karamo/esp32-e22-lora-board/ESP32-E22-PCB_ChatExport_2026-04-16/chats/chat_562951940640114/topic_11812/photos/photo_120@05-12-2025_15-44-13.jpg

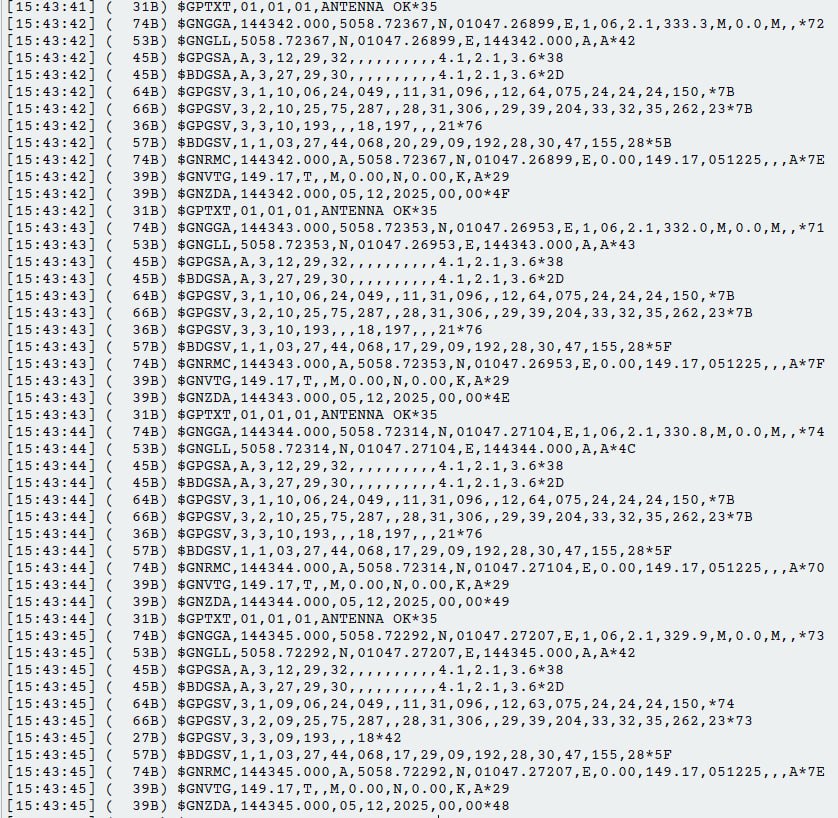
ESP32-E22-PCB_ChatExport_2026-04-16/chats/chat_562951940640114/topic_11812/photos/photo_120@05-12-2025_15-44-13.jpg
