karamo/esp32-e22-lora-board/ESP32-E22-PCB_ChatExport_2026-04-16/chats/chat_562951940640114/topic_11812/photos/photo_38@24-03-2025_12-01-31.jpg

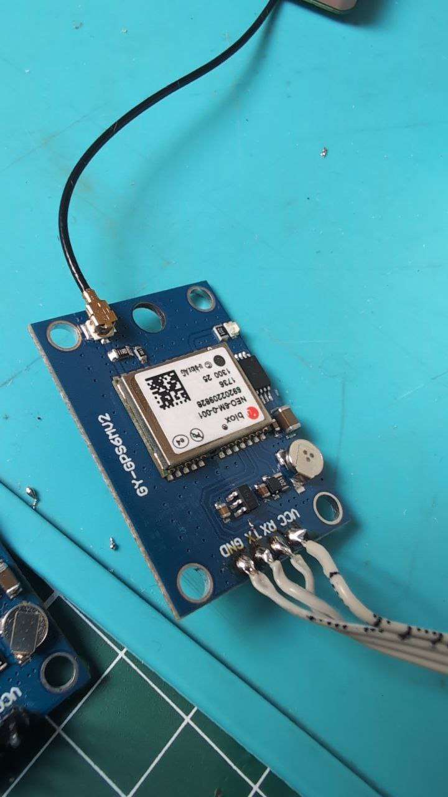
ESP32-E22-PCB_ChatExport_2026-04-16/chats/chat_562951940640114/topic_11812/photos/photo_38@24-03-2025_12-01-31.jpg
