karamo/esp32-e22-lora-board/README.md

# ESP32-E22-LoRa-board
Carrier Board for LoRa Tranceiver like E22-400M33S and ESP32 MCU

### Main Parts List:

EBYTE E22-400M33S (2W/33dBm) https://www.amazon.de/dp/B0BMP99S3D

if needed: E22->N Pigtail: https://www.amazon.de/dp/B0C8J131PD

ESP32 Board Dev Kit C V4 **!!! von AZ Delivery nicht mehr verfügbar !!!**  
https://www.amazon.de/AOICRIE-ESP32-DevKitC-Kernplatine-ESP32-Entwicklungsplatine-ESP32-WROOM-32D-WiFi-Bluetooth-Entwicklungsplatine/dp/B0B8VRPN36  
https://de.aliexpress.com/item/4000090521976.html

Adapter-Kabel zum flashen im eingebauten Zustand https://www.amazon.de/dp/B096843RY3/

BME/BMP280 3,3V https://www.amazon.de/dp/B07FS95JXT/

OLED-Display (VCC-GND-SCL-SDA): https://www.amazon.de/dp/B0C9LJ898Z/

GPS https://www.amazon.de/dp/B0D3DJ58R8/

Reichelt: https://www.reichelt.de/my/2192127

### Versions Info
**V 2.1.2  PCB** für Querformat im Gehäuse für Aussenmontage - alle Anschlüsse auf der Unterseite des Gehäuses  
oder PCB vertikale Einbau

___
