karamo/esp32-e22-lora-board/ESP32-E22-PCB_ChatExport_2026-04-16/chats/chat_562951940640114/topic_11812/files/at6558.pdf_thumb.jpg

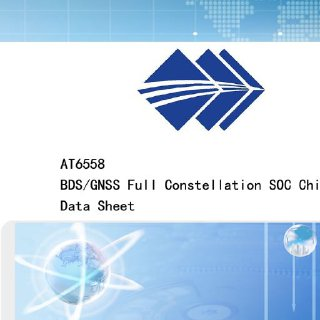
ESP32-E22-PCB_ChatExport_2026-04-16/chats/chat_562951940640114/topic_11812/files/at6558.pdf_thumb.jpg
