karamo/esp32-e22-lora-board/ESP32-E22_V2.1.2/PCB-Assembly/README.md

# Bestückungshinweise PCB V2.1.2

Bestückungsreihenfolge, Varianten und Inbetriebnahme des PCB V2.1.2  

Bilder zum fertigen Gerät sind hier zu finden:  
https://github.com/DK9BT/esp32-e22-lora-board/tree/main/ESP32-E22_V2.1.2/pdf  
Fertig bestückte Varianten sind hier zu finden:  
https://github.com/DK9BT/esp32-e22-lora-board/tree/main/gallery

## 1) Minimalbestückung
* Die folgenden BT sind das absolute Minimum für die grundsätzliche Funktion.
* Über die USB-mikro Buchse am ESP32 kann auch das E22-Modul versorgt werden, wenn ein passendes USB-Netzgerät verwendet wird, welches mind. 2A bereitstellen kann.

### 1.1 Key-Components
* **PCB V2.1.2**
* **U1 = ESP32-DevKitC-V4**
* **U2 = OLED 0,96"**
* **U3 = E22-400M30S** (30dBm) od. **E22-400M33S** (33dBm) od. **E22-900M30S** (30dBm!)

### 1.2 Einbau-Varianten für U3 = E22-fffM3xS
> [!NOTE]
> **Dieses BT sollte als Erstes bestückt werden, um gut an die Lötstellen zu kommen.**

**a)** Das **E22-Modul** ist für **SMD-Direktlötung** vorgesehen. Der NT ist, dass es bei einem Defekt schwieriger abzulöten ist.  
E22-direkt  

**b)** **E22-Modul auf Sockel (Variante für PCB V2.1.2)**  
Obwohl der Pin-Abstand des E22-Moduls 2,50mm beträgt, ist es trotzdem möglich, Stifte und Buchsen im RM 2,54 zu verwenden.  
Bei dieser Art der Bestückung wird sozusagen ein Stecksockel aus einfachen, günstigen und handelsüblichen Teilen hergestellt.  
In einer späteren Version wird es eine Sockeladapterplatine geben und eine modifizierte PCB.

<ins>**Schritt 1:**</ins> Durchkontaktierte Lochrasterplatte 35x27mm (13x10 Löcher) mit **2x 8pol** + **2x 3pol Pfosten-Buchsen** bestücken und mit Stiftleisten stabilisieren.  
E22_sockelPCBE22_SocBu  

<ins>**Schritt 2:**</ins> verlöten und Lötstellen plan feilen, damit das E22-Modul plan aufliegen kann und gut verlötbar ist.  
E22_SoctopE22_Socbot  

<ins>**Schritt 3:**</ins> **2x 8pol** + **2x 3pol Pfostenstecker gewinkelt** zur Stabilisierung in die Pfosten-Buchsen stecken und das kürzere Ende noch weiter kürzen.  
E22_SMD90E22_SMDa  

<ins>**Schritt 4:**</ins> auf die PCB wie ein SMD-BT auflöten.  
E22_SMDb  

<ins>**Schritt 5:**</ins> **C3** (220..470µF, liegender Einbau) & **C4** (100nF) bestücken.

### 1.3 Einbau-Varianten für U1 = ESP32-DevKitC V4
Die **V4** ist die derzeit neueste Version. Es können aber grundsätzlich auch die **V1**- od. **V4**-Module verwendet werden.  
> [!NOTE]
> Die Unterschiede werden an anderer Stelle detailliert dargestellt. [!TODO]

* **a)** Normalerweise verwendet man eine Pfosten-Steckverbindung, wobei die Buchsenleisten in das PCB eingelötet sind und die Pfostenstecker sich am ESP32-Modul befinden, **je 2x 19-pol**:  
ESP32_BuLeiste  

* **b)** Es können aber auch IC-Sockelstifte & Sockelbuchsen verwendet werden. Dies hat den Vorteil, dass das ESP32-Modul problemlos auf ein Steckbrett eingesteckt werden kann.  
ESP32_IC-Sockel  

### 1.4 OLED 0,96"
Für das OLED sind 2 Positionen 0°=Hochformat & 90°=Querformat (J11) vorgesehen, die mit **2x 4-pol Bu-Streifen** bestückt werden.  
Die OLED gibt es in grundsätzlich 2 verschiedenen Pin-Anordnungen. Die angegebene (**VCC-GND-SCL-SDA**) ist bereits auf der PCB verdrahtet. Falls man VCC <> GND umdrehen möchte, dann sind auf der Rückseiten 2 Leiterbahnen zu unterbrechen und 2 Drahtbrücken herzustellen (JP1 & JP2).  
Bei manchen OLEDs (rechts im Bild) kann man noch die **I²C**-Adresse von **`0x78`** auf **`0x7A`** ändern.  
Mit einem I²C-Scanner werden **`0x78` >> `0x3C`** und **`0x7A` >> `0x3D`** erkannt (7-Bit Format).  
Zusätzlich können auf manchen Modulen direkt die **VCC<>GND** durch die **J1/J2/J3/J4** im Foto rechts vertauscht werden.  
Das linke OLED verwendet einen **SH1106**-Driver (132x64 pixel), das rechte einen **SSD1306**-Driver (128x64 pixel).  
OLED_SH1106-SSD1306  
Das OLED-Board kann über eine Abstandshülse Ø4x11 mit M2 Gewindebohrung beidseits mit M2x5 Schrauben auf dem PCB mechanisch fixiert werden.  
U1+U2+C3+C4OLEDfix

### 1.5 User Button
Ein Taster **SW1** ist an **GPIO12** angeschlossen. Parallel dazu kann über **J10** ein Taster extern, zB. am Gehäuse, verbunden werden.  
Für **MeshCom** muss er erstmalig mit **`--button on`** aktiviert werden.  
Button

### 1.6 Testlauf #1
Beim Online-Flash Tool https://esptool.oevsv.at/ ist **E22** auszuwählen. (Hat auch eine Console. Chromium Browsers only!)  
Und läuft grundsätzlich, mit Minimalbestückung und auch ohne HF (E22).  
Testlauf1

### 1.7 Varianten Antenne
* Das E22-Modul hat einen IPEX-Stecker. Hier kann eine Antenne angeschlossen werden über
  * ein **IPEX-SMA-Buchse Adapterkabel** oder
  * als Gehäusedurchführung eine dichte **U.FL IPEX <> N-Buchse** https://www.amazon.de/dp/B0C8J131PD oder
  * Alternativ eine IPEX <> SMA-Einbaubuchse: ...
 
* Beim Einbau der **SMA-Buchse J8 + R8** (0Ω=Drahtbrücke auf der Rückseite) über
  * einen SMA-St <> N-Bu mit Flansch, aber ohne Dichtung (ev. Dichtfolie verwenden):
https://www.reichelt.at/at/de/shop/produkt/hf_n_buchse_sma_flanschbuchse-141249
  * eine SMA-Bu <> SMA-Bu:  
https://www.conrad.at/de/p/bkl-electronic-0409093-0409093-sma-adapter-sma-buchse-sma-buchse-1-st-457659.html

Bei allen Varianten ist eine mechanische Entkopplung zwischen Antenne<>Gehäuse<>PCB gegeben.  

## 2) Spannungsversorgung
Für die Spannungsversorgung stehen mehrere Möglichkeiten zur Verfügung.  
### ❗ 🟡 Extrem wichtig ist aber, dass die 2x 470µF Elkos und alle 100nF KerKos bestückt sind, und dass ein Netzgerät mit ausreichender Stromergiebigkeit verwendet wird! Bei hochwertigen Netzteilen sollten 2A reichen, das die Stromspitzen auch wegpuffern kann. Besser sind Netzteile mit 3A nominell, wie sie z.B. auch für RaspberryPi verwendet werden. Und möglichst kurze und niederohmige Verbindungsleitung zwischen Netzgerät und PCB.
### ❗ 🟡 Ebenso sollte C2 10µF NICHT bestückt werden, bei Verwendung des ESP32-DevKitC-V4 Moduls!

### 2.1 USB-Micro via ESP32
Die Spannungsversorgung kann über die USB-Mikro-Buchse des ESP32-Moduls erfolgen, wenn ein geeignetes USB-Netzteil verwendet wird, welches bis zu 3A liefern kann. Mindestens jedoch 2,5A. Solche Netzteile werden z.B. auch für die Versorgung von RapberryPi u.a. verwendet.  

### 2.2 Versorgung über USB-C
Das **USB-C BreakOut-Board** mit der stehenden USB-C Buchse ermöglicht ein leichtes Anstecken der externen Versorgung, speziell bei Einbau in ein Gehäuse. https://de.aliexpress.com/item/1005007821332638.html  

<ins>**Funktion:**</ins>  
Für USB-C PD (Power Delivery) ist ein Kommunikations-IC an CC1 & CC2 erforderlich.
Wenn dieser nicht vorhanden ist, dann kann nur 5V geliefert werden und über die Widerstände an CC1 & CC2 wird der Strom "eingestellt". Die Widerstände **R3** & **R4** mit jeweils **5k1** signalisieren dem USB-Netzteils, dass es **5V/3A** liefern darf. Die Schottky-Diode **D1** verhindert eine Rückspeisung, falls mehrere Spannungsquellen angeschlossen sind.  

<ins>**Schritt 1:**</ins> Die Widerstände **R3** & **R4** (je 5k1) auf der Rückseite bestücken und auf der Oberseite Lötpins auf ein Minimum kürzen.  
R3-R4  

<ins>**Schritt 2:**</ins> Die Diode **D1** und eine längere **4-pol** Stiftleiste **J2** mit Gesamtlänge **15mm** auf der Oberseite bestücken.  
Dann 2-3 Lagen Doppelklebepads zur Unterstützung des USB-C Adapter Boards aufbringen ...  
J2-D1  

<ins>**Schritt 3:**</ins> das USB-C Adapter Board aufkleben und verlöten. An die überstehende Stiftleiste kann eine USB-C Einbaubuchse mit Kabel angesteckt werden.  
USB-Bu  

Die Versorgung über die USB-C-Buchse funktioniert.  
USB-C_ok  

### 2.3 Versorgung über DC/DC HW-613
> [!NOTE]
> Funktionsbeschreibung [!TODO]
Bei Versorgung über ein externes Netzgerät über Schraubklemmen ist zwar auch eine Schottky-Diode erforderlich, aber bei Verwendung des **DC/DC-Wandler-Boards HW-613** (bis 1,5A) kann mit bis zu 6-24V DC versorgt werden und die Ausgangsspannung kann eingestellt werden, bzw. fix durch Lötbrücken.  

**D5** 1N4007 o.ä. & **C5** 100nF bestücken  
D5C5  

Eine 4-pol Stiftleiste auf den DC/DC-Wandler **U4 HW-613** löten.  
DCDC  
> [!IMPORTANT]
> Auf einem Steckbrett den DC/DC-Wandler mit dem Poti auf **5,3V** Ausgangsspannung einstellen.

> [!CAUTION]
> Es ist nicht zu empfehlen, die ADJ-Leiterbahn zu unterbrechen und den 5V-Jumper zu löten, ausser man hat ein sehr gute Lupe (Mikroskop) und entsprechendes Schneidwerkzeug. Siehe https://protosupplies.com/product/mp2315-mini-adjustable-dc-dc-step-down-module/  
> DCDCjmp  

[img U4 eingelötet] & D2 auf Oberseite & J3  

Weitere BT: C6, D4 (alternativ D3)  
Weitere BT: F1, D5  
• Zusätzlich ist eine **2A** Feinsicherung **F1** und eine Schutzdiode **D5** (1N4004..1N4007) gegen Verpolung eingebaut.  
• Die Transient Voltage Suppressor Diode **D4** (alternativ **D3**) schützt vor ESD mit einer VBR = 5,6V min. @ I=1mA

### 2.4 Versorgung über DC/DC R-78B5.0-2.0
Statt dem günstigen DC/DC in [2.3](https://github.com/DK9BT/esp32-e22-lora-board/blob/main/ESP32-E22_V2.1.2/PCB-Assembly/README.md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) kann auch ein handeslsüblicher, aber auch teurerer Schaltregler z.B. der **RECOM R-78B5.0-2.0** verwendet werden.  
https://at.rs-online.com/web/p/schaltregler/1392959  
https://www.conrad.at/de/p/recom-r-78k5-0-2-0-dc-dc-wandler-5-v-2-a-10-w-inhalt-1-st-2887420.html  
[img 3D]

### 2.5 Versorgung über USB-C Einbaubuchse
An die überstehende Stiftleiste **J2** kann eine USB-C Einbaubuchse mit Kabel angesteckt werden.  
[Foto !TODO]

### 2.6 weiter Versorgungsmöglichkeiten (Rohfassung aus Telegram)

❗️Ich habe viele Möglichkeiten vorgesehen. Man kann einiges weglassen, wenn man weiß, was man tut. Aber man sollte auch die Schaltung verstehen.  
1️⃣ Schraubklemme kann verwendet werden, auch ohne DC/DC. Drahtbrücke einbauen.  
2️⃣ Sicherung F1 & Diode D5 müssen nicht verwendet werden, können aber.  
3️⃣ Auf die Stiftleiste J2 kann eine USB-C Einbaubuchse angesteckt werden.

• z.B. die **6-polige (VCC GND CC1 CC2 D+ D-)**, wobei ich aber noch keine genaue Belegung dazu gefunden habe.  
grafik

• es kann auch sein, dass die **5-polige (VCC GND CC D+ D-)** funktioniert. Davon habe ich eine Belegung gefunden. Wahrscheinlich gemeinsames CC, also CC1-CC2 verbunden, was aber zu dem bekannten RPi-Problem führt.
grafik

❌ Die **2-poligen (nur VCC & GND)** und die **4-poligen (VCC & GND & D- & D+)** funktionieren aber definitiv NICHT, da die CC1 & CC2 Anschlüsse fehlen und daher von dem USB-C Netzteil nur 5V/500mA bereitgestellt werden darf, außer ev. Ausnahmen, wenn man "dumme" Netzteile u/o "dumme" USB-C Anschlusskabel verwendet.

## 3) Einbau in ein Gehäuse
Enclosure (transparent) https://www.reichelt.de/de/de/shop/produkt/industriegehaeuse_120_x_80_x_60_2mm_ip65_lichtgrau-340524  
Enclosure (non-transparent) https://www.reichelt.de/de/de/shop/produkt/industriegehaeuse_120_x_80_x_60_2mm_ip65_lichtgrau-340515  
Gehäuse Maßzeichnung: https://cdn-reichelt.de/documents/datenblatt/C700/6U07120806437_6U-120806_DB.pdf  

* Das Gehäuse verfügt über 8 Stk. Sacklöcher Ø3,2x4. Die in den Ecken sind für die Befestigung der PCB vorgesehen. Die Sacklöcher auf den Seiten können für die Befestigung eines 3D-Druck Einbauteils verwendet werden.
* Darin können **M2x4x3,5 Einpressmutter** eingeschmolzen werden, wenn keine Schraubklemme+DC/DC-Wandler verwendet werden.
* Bei Verwendung der Schraubklemme + DC/DC-Wandler, der auf der Rückseite der PCB platziert ist, muss ein größerer Abstand der PCB vom Gehäuseboden durch Verwendung von **M2x6x3,5 Einpressmuttern** eingehalten werden.
* Alternativ können auch Abstandsröhrchen L≥1,5mm verwendet werden (z.B. Ms-Rohr Ø3) und M2x8 Schrauben.
* !!! für den erhöhten Einbau der PCB ins Gehäuse wird es ein 3D-Druck-Teil geben!
* Bei anderem Bedarf können aber auch die Befestigungsbohrungen auf der PCB aufgebohrt werden.  
Einpressbuchse_M2x4x3,5  

Für das wasserdichte Gehäuse ist eine Druckausgleichsmembran zu empfehlen, damit das Wasser auch wieder herausdiffundieren kann. Sonst steht irgendwann die Leiterplatte unter Wasser.  
z.B. https://shop.bb-sensors.com/Druck/Drucksensoren/Druckausgleich-Membran-VPE-12-Stueck.html  
oder https://www.reichelt.at/at/de/shop/produkt/druckausgleichselement_m12_schwarz_2_stueck-371154  
oder https://www.amazon.de/dp/B088QJG676

Je nach Aufstellungsort kann auch eine einfache ≈Ø2mm Bohrung zum Druckausgleich ausreichen.  

### 3.1 Programmierkabel für ESP32
Dieses könnte wegen der nur 20cm im Gehäuse verbleiben:  
https://www.reichelt.at/at/de/shop/produkt/dual_easy_usb_2_0_kabel_a_st_auf_micro_b_st_gew_0_2_m-287766  
oder es kann ein Winkeladapter verwenden werden: https://www.amazon.de/dp/B0CRVH7JRD  

## 4) Sensoren
### 4.1 GPS
GPS wird hier am **J4** angesteckt. Für die GPS-Antenne ist "rechts oben" neben der SMA-Buchse die Platine ausgespart. Da ist Platz im Gehäuse, die Antenne parallel zur Seitenwand anzubringen.  
Hierfür wurde von **DF2PI** ein 3D-Druckteil entworfen:  
https://www.printables.com/model/1135886-montagebrucke-interne-gps-antenne-gps-board-fur-me  

grafik

grafik

In der `configuration.h`  
`#define GPS_RX_PIN 16` **<= TX am GPS-Modul**  
`#define GPS_TX_PIN 17` **=> RX am GPS-Modul**

### 4.2 BME/BMP 280
Hier ist **J6** vorgesehen.  
Sensor **BME280 Board 10,5 x 13,2 mm**
- Ein  **BME280** hat ein fast quadratisches Gehäuse mit Luftloch in der Mitte. (Im Gegensatz zu einem **BMP280**, der ein rechteckiges Gehäuse mit Luftloch in einer Ecke hat.)
- Da der Chip von 1,8 .. 3,3V (4,25V max.) funktioniert und - wie ersichtlich - ein LDO + Level-Shifter auf der Rückseite sind, sind diese Ausführungen für 3,3V und auch 5V geeignet.
- im linken Bild oberhalb der Beschriftung sind 3 Pads: hier kann die I²C-Adresse auf 0x77 geändert werden, wenn das mittlere Pad mit dem linken - offenbar GND - verbunden wird. Wenn nach VDD (rechts) oder offen, dann std. 0x76.
- Ein **BME280** misst **interne Chip-Temperatur, Druck und Luftfeuchtigkeit**.  
grafik
grafik

### 4.3 INA226
Hier ist **J7** vorgesehen. ❗ versetzt an 5-pol J7 anstecken. Die Bohrung oberhalb ist für mechanische Befestigung des Boards gedacht, wenn das Board horizontal eingebaut wird.  
Mit dem Befehl `--shunt {0.001 .. 0.5}` kann der Shunt-Widerstand des INA226-Moduls definiert werden. Kann auch zur Kalibrierung verwendet werden.  
grafik

___
## 98) weitere Hinweise
* **C2** ist bei Verwendung des **ESP32-DevKitC-V4** nicht erforderlich. Die Anschlüsse können für einen externen Reset-Taster verwendet werden.
* **R1, R2, C1, J1** nur dann bestücken, wenn man eine Spannung messen will. Hierfür sind die Widerstände, dh. der Spannungsteiler,
 so zu wählen, dass die Spannung am ADC-Eingang des ESP32 max. 3,2V erreicht.
* **R6 & R7** (PullUp-Widerstände für I²C-Bus) nur dann bestücken, wenn Probleme mit I²C-Komponenten auftreten. Hierbei aber feststellen, ob die verbundenen I²C-Boards schon selber PullUp-Widerstände enthalten.

___
# 99) Allgemeine Hinweise
* Die Schaltung ist nach den gängigen Regeln der Technik konzipiert und hergestellt. Es wurde jedoch nicht geprüft ob allfällige Normen eingehalten werden.
* Die hier angegebenen Hinweise sind lediglich eine Beschreibung einer Möglichkeit des Zusammenbaus.
* Die Inbetriebnahme erfolgt eigenverantwortlich.
* Ich weise auf die gesetzlichen Bestimmungen bez. Elektrogeräten, Funkanlagen u.ä. hin, die von jedem Anwender selber einzuhalten sind.

___
***:copyright: 24.11.2025 10:10 by OE3WAS - Wolfgang***
