karamo/esp32-e22-lora-board/ESP32-E22_V2.1.2/KiCad/esp32-e22.kicad_pcb

## KiCad design ESP32-E22_V2.1.2/KiCad/esp32-e22.kicad_pcb (2026-01-03)

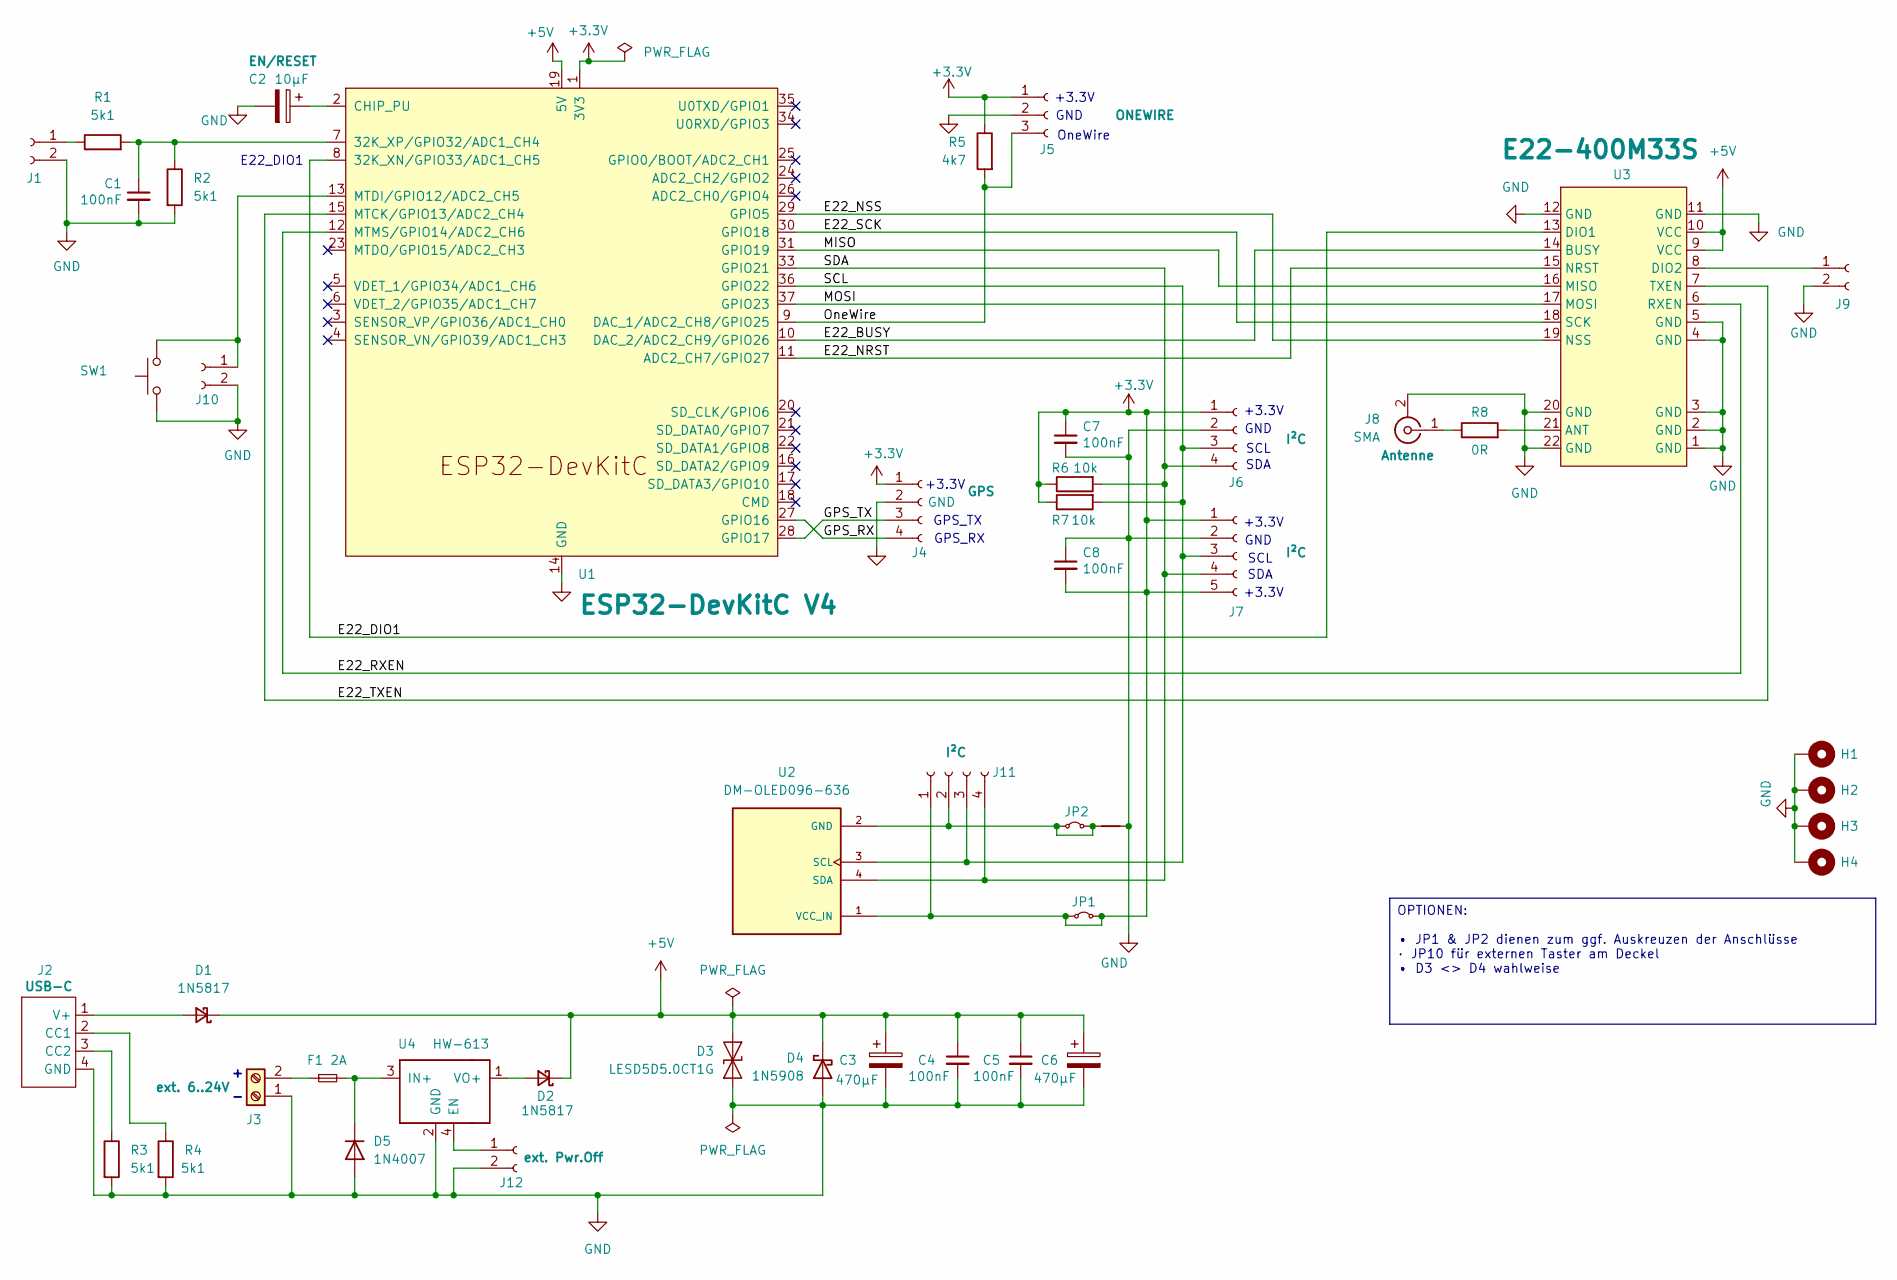
[picture p114: schematic esp32-e22.kicad_sch, ESP32 - E22 Board]

Parts:
C1, C4, C5, C7, C8: 100nF; C_Disc_D4.7mm_W2.5mm_P5.00mm
C2: 10µF; CP_Radial_D6.3mm_P2.50mm
C3, C6: 470µF; CP_Radial_D5.0mm_P2.50mm
D1: 1N5817; D_DO-41_SOD81_P5.08mm_Vertical_KathodeUp
D2: 1N5817; D_DO-41_SOD81_P7.62mm_Horizontal
D3: LESD5D5.0CT1G; D_SOD-523
D4: 1N5908; D_DO-201_P12.70mm_Horizontal
D5: 1N4007; D_DO-41_SOD81_P2.54mm_Vertical_KathodeUp
F1: 2A; R_Axial_DIN0411_L9.9mm_D3.6mm_P5.08mm_Vertical
H1, H2, H3, H4: MountingHole_Pad; MountingHole_2.2mm_M2_Pad_TopBottom
J1, J9, J10: Conn_01x02_Socket; PinHeader_1x02_P2.54mm_Vertical
J2: USB-C_vert
J3: Screw_Terminal_01x02; TerminalBlock_Phoenix_MKDS-1,5-2-5.08_1x02_P5.08mm_Horizont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
J4: Conn_01x04_Socket; PinHeader_1x04_P2.54mm_Vertical
J5: Conn_01x03_Socket; PinHeader_1x03_P2.54mm_Vertical
J6, J11: Conn_01x04_Socket; PinSocket_1x04_P2.54mm_Vertical
J7: Conn_01x05_Socket; PinSocket_1x05_P2.54mm_Vertical
J8: SMA; SMA_Amphenol_901-143_Horizontal
J12: Conn_01x02_Socket; PinHeader_1x02_P2.54mm_Horizontal
JP1, JP2: Jumper_2_Small_Bridged; TestPoint_2Pads_Pitch2.54mm_Drill0.8mm
NT1: NetTie_2; NetTie-2_SMD_Pad0.5mm
R1, R2, R3, R4: 5k1; R_Axial_DIN0207_L6.3mm_D2.5mm_P7.62mm_Horizontal
R5: 4k7; R_Axial_DIN0207_L6.3mm_D2.5mm_P7.62mm_Horizontal
R6, R7: 10k; R_Axial_DIN0207_L6.3mm_D2.5mm_P7.62mm_Horizontal
R8: 0R; R_0805_2012Metric
SW1: SW_Push; SW_PUSH_6mm
U1: ESP32-DevKitC V4; ESP32-DevKitC
U2: DM-OLED096-636; PARTREV 2018-09-10
U3: E22-400M33S
U4: HW-613

Connections:
+3.3V: C7.1, C8.2, J4.1, J5.1, J6.1, J7.1, J7.5, J11.1, JP1.1 (A), JP1.2 (B), R5.1, R6.1, R7.1, U1.1 (3V3), U2.1 (VCC_IN)
+5V: C3.1, C4.1, C5.1, C6.1, D1.1 (K), D2.1 (K), D3.1 (A1), D4.1 (K), U1.19 (5V), U3.9 (VCC), U3.10 (VCC)
/E22_BUSY: U1.10 (DAC_2/ADC2_CH9/GPIO26), U3.14 (BUSY)
/E22_DIO1: U1.8 (32K_XN/GPIO33/ADC1_CH5), U3.13 (DIO1)
/E22_NRST: U1.11 (ADC2_CH7/GPIO27), U3.15 (NRST)
/E22_NSS: U1.29 (GPIO5), U3.19 (NSS)
/E22_RXEN: U1.12 (MTMS/GPIO14/ADC2_CH6), U3.6 (RXEN)
/E22_SCK: U1.30 (GPIO18), U3.18 (SCK)
/E22_TXEN: U1.15 (MTCK/GPIO13/ADC2_CH4), U3.7 (TXEN)
/GPS_RX: J4.4, U1.27 (GPIO16)
/GPS_TX: J4.3, U1.28 (GPIO17)
/MISO: U1.31 (GPIO19), U3.16 (MISO)
/MOSI: U1.37 (GPIO23), U3.17 (MOSI)
/OneWire: J5.3, R5.2, U1.9 (DAC_1/ADC2_CH8/GPIO25)
/SCL: J6.3, J7.3, J11.3, R7.2, U1.36 (GPIO22), U2.3 (SCL)
/SDA: J6.4, J7.4, J11.4, R6.2, U1.33 (GPIO21), U2.4 (SDA)
GND: C1.2, C2.2, C3.2, C4.2, C5.2, C6.2, C7.2, C8.1, D3.2 (A2), D4.2 (A), D5.2 (A), H1.1, H2.1, H3.1, H4.1, J1.2, J2.4 (GND), J3.1, J4.2, J5.2, J6.2, J7.2, J8.2 (Ext), J9.2, J10.2, J12.2, NT1.2, R2.2, R3.2, R4.2, SW1.1, U1.14 (GND), U1.32 (GND), U1.38 (GND), U3.1 (GND), U3.2 (GND), U3.3 (GND), U3.4 (GND), U3.5 (GND), U3.11 (GND), U3.12 (GND), U3.20 (GND), U3.22 (GND), U4.2 (GND)
unnamed: D1.2 (A), J2.1 (V+)
unnamed: D2.2 (A), U4.1 (VO+)
unnamed: D5.1 (K), F1.2, U4.3 (IN+)
unnamed: J1.1, R1.1
unnamed: J2.2 (CC1), R4.1
unnamed: J2.3 (CC2), R3.1
unnamed: F1.1, J3.2
unnamed: J8.1 (In), R8.1
unnamed: J9.1, U3.8 (DIO2)
unnamed: J10.1, SW1.2, U1.13 (MTDI/GPIO12/ADC2_CH5)
unnamed: J11.2, JP2.1 (A), JP2.2 (B), NT1.1, U2.2 (GND)
unnamed: J12.1, U4.4 (EN)
unnamed: C1.1, R1.2, R2.1, U1.7 (32K_XP/GPIO32/ADC1_CH4)
unnamed: C2.1, U1.2 (CHIP_PU)
unnamed: R8.2, U3.21 (ANT)

Notes on the sheet:
GND
SCL
+3.3V
GPS_TX
OneWire
SDA
GPS_RX
E22_DIO1
OPTIONEN: • JP1 & JP2 dienen zum ggf. Auskreuzen der Anschlüsse · JP10 für externen Taster am Deckel • D3 <> D4 wahlweise

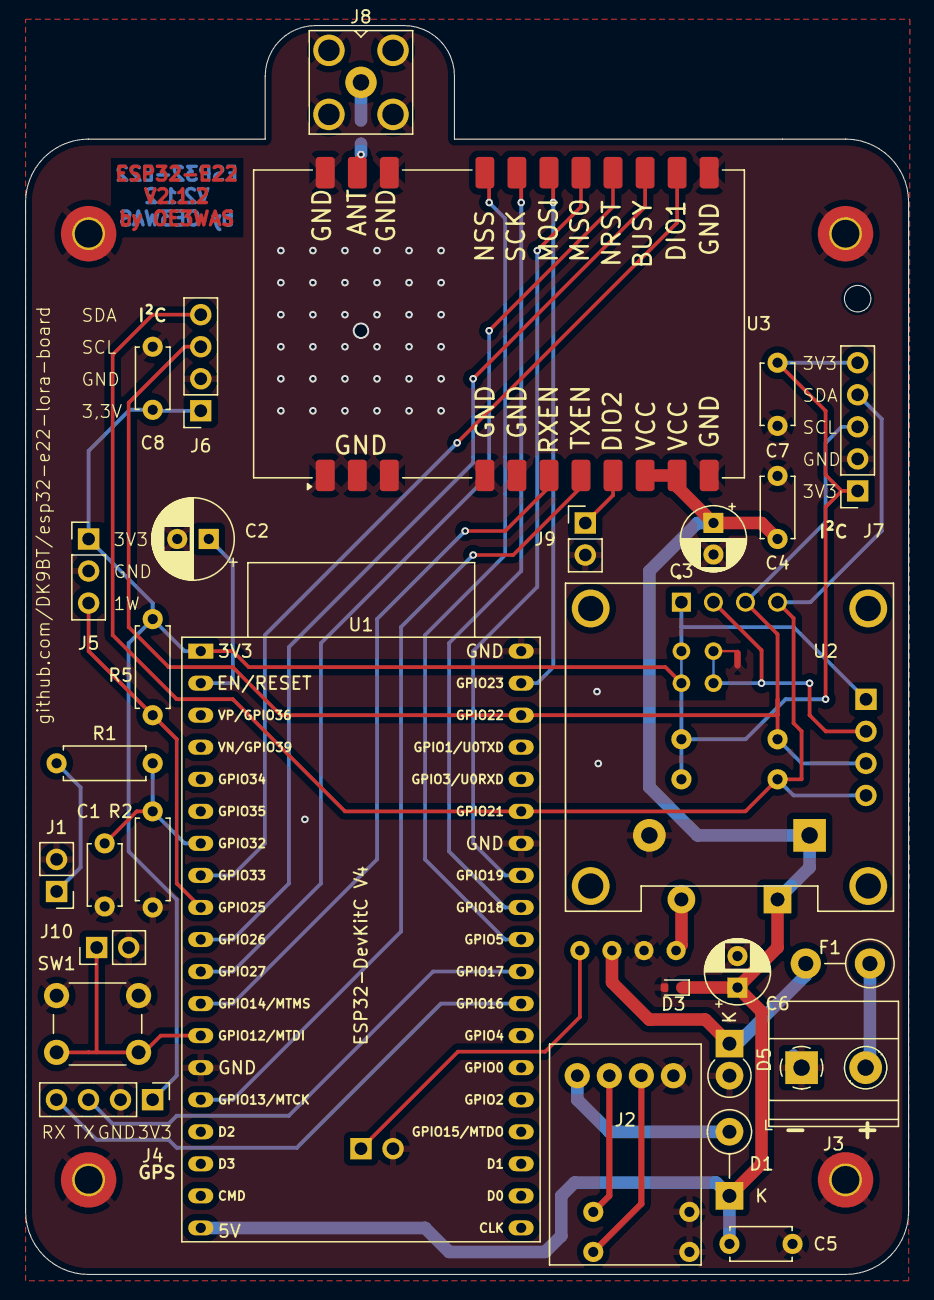
[picture p115: board esp32-e22.kicad_pcb from above]

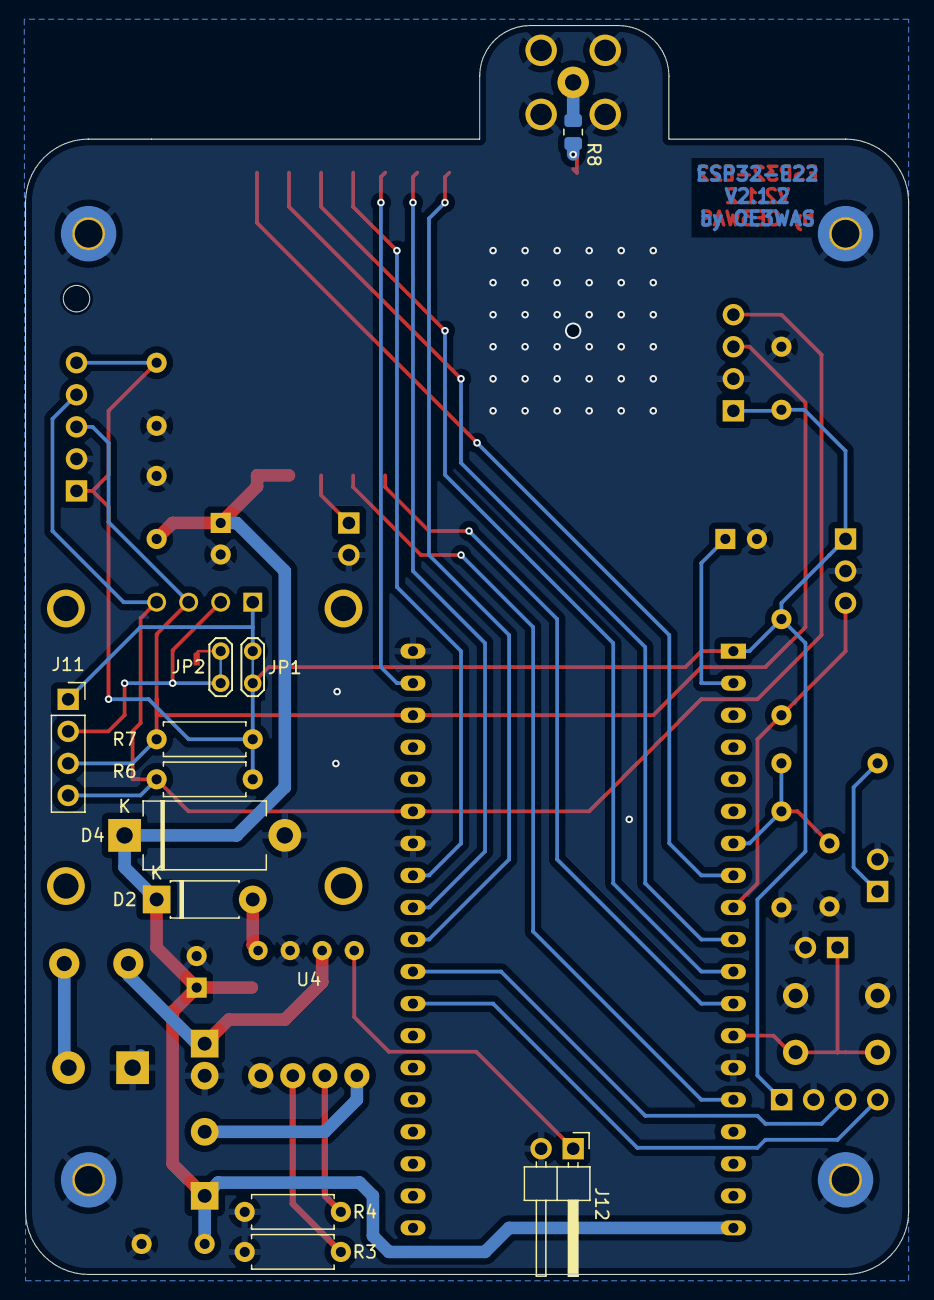
[picture p116: board esp32-e22.kicad_pcb from below]

Board: 2 copper layers, 70.0 x 99.0 mm, 46 parts (12 on the bottom side), 32 nets.
