karamo/esp32-e22-lora-board/(commit log)

2026-04-17 Add Q&A section for ESP32-E22 PCB development
    This commit adds a new Q&A section for the ESP32-E22 PCB, documenting discussions and updates related to its development, including changes in version V2.1.2 and component sourcing.
2026-04-17 Update print statement from 'Hello' to 'Goodbye'
2026-04-17 Clean up Q&A section in ESP32-E22-PCB.md
    Removed conversation snippets and irrelevant comments from the Q&A section.
2026-04-17 Revise Q&A for ESP32-E22 PCB with updated links
    Updated links and notes for PCB V2.1.2 documentation.
2026-06-05 Correct diode part number in README.md
2026-10-31 Revise ESP32 Board link and availability information
    Updated ESP32 Board Dev Kit C V4 link and added availability note.
2026-10-31 Revise Q&A document for ESP32-E22 PCB
    Updated document to reflect changes in project links and information regarding the ESP32-E22 PCB. Removed outdated links and added notes about component specifications.
2026-10-31 Revise Q&A for ESP32-E22 PCB with user insights
    Updated the Q&A section for the ESP32-E22 PCB, including clarifications on OLED pin arrangements, power supply considerations, and user experiences with various components.
